Zachnad0/KICAD_DC-DC_Converter_AnalogControlSys_Mk-I/LTspiceSim/Module_2_SwitchingRegController.asc

C1: cap; 100n
C2: cap; 10n
C3: cap; 100n
C4: cap; 10n
C5: cap; 2.2µ
C6: polcap; 220µ; Rser=120m
C8: cap; 1µ; Rser=1m
D1: diode; 1N5819
I1: current; 0.4
L1: ind; 22µ; Rser=30m
M1: nmos; IPB039N04L
R1: res; 1k
R2: res; 10k
R3: res; 10k
R4: res; {R_trigGain}
R5: res; 10k
R6: res; 30k
R7: res; 1k
R8: res; 150k
R9: res; 13.2k
R10: res; 10k
R11: res; 10k
R14: res; 1k
R15: res; 1k
R16: res; 5.1k
R17: res; 1k
R18: res; 2.2k
R19: res; 2.2k
R20: res; {R_osc}
R21: res; 10k
R22: res; 12.2k
R23: res; 30k
R24: res; 10k
U1: UniversalOpAmp2; Avol=200k GBW={GBW} Slew={slewRate}; Ilimit=40m Rail={railV} Vos=0
U2: UniversalOpAmp2; Avol=200k GBW={GBW} Slew={slewRate}; Ilimit=40m Rail={railV} Vos=0
U3: UniversalOpAmp2; Avol=200k GBW={GBW} Slew={slewRate}; Ilimit=40m Rail={railV} Vos=0
U4: UniversalOpAmp2; Avol=200k GBW={GBW} Slew={slewRate}; Ilimit=40m Rail={railV} Vos=0
U5: UniversalOpAmp2; Avol=200k GBW={GBW} Slew={slewRate}; Ilimit=40m Rail={railV} Vos=0
U6: UniversalOpAmp2; Avol=200k GBW={GBW} Slew={slewRate}; Ilimit=40m Rail={railV} Vos=0
U7: UniversalOpAmp2; Avol=200k GBW={GBW} Slew={slewRate}; Ilimit=40m Rail={railV} Vos=0
U8: UniversalOpAmp2; Avol=200k GBW={GBW} Slew={slewRate}; Ilimit=40m Rail={railV} Vos=0
V2: voltage; 5
V3: voltage; 5
V5: voltage; 5
V6: voltage; 5
Named nets: V_CC, V_EE, 0, V_CLK, V_THR, V_PWM, C, D, V_O, V_TARG, E, error, integral_error, B, nMOS, V_supply
.tran 0 40m 0 0.1u startup
.meas TRAN V_b_max MAX V(b)
.param R_trigGain = 17.7k
.meas TRAN R_f1_optimal PARAM {(2.5 / V_b_max - 1) * 10k}
.param slewRate = 15Meg
.param GBW = 3Meg
.meas TRAN P_AVG_SUPPLY AVG {abs( V(V_supply) * I(V5) )} FROM 15m
.meas TRAN P_AVG_FET AVG {V(nMOS) * Id(M1)} FROM 15m
PWM Gen.
Pot. #1
PI Controller
Boost Converter
Hysterisis 100kHz Square Oscillator (+/- 10% tol.)
.param R_osc = 4.9k
Pot. #2
Supply and Target Voltages
.meas TRAN P_AVG_LOAD AVG {abs( V(V_O) * I(I1) )} FROM 15m
.meas TRAN P_EFFICIENCY PARAM {P_AVG_LOAD / P_AVG_SUPPLY}
.meas TRAN I_AVG_D1 AVG {I(D1)} FROM 10m
.meas TRAN P_AVG_D1 AVG {abs(V(nMOS,V_O) * I(D1))} FROM 15m
.param railV = 1
