Zachnad0/KICAD_DC-DC_Converter_AnalogControlSys_Mk-I/DC-DC_Converter_AnalogControlSys_Mk-I.kicad_pcb

## KiCad design DC-DC_Converter_AnalogControlSys_Mk-I.kicad_pcb (2025-12-18)

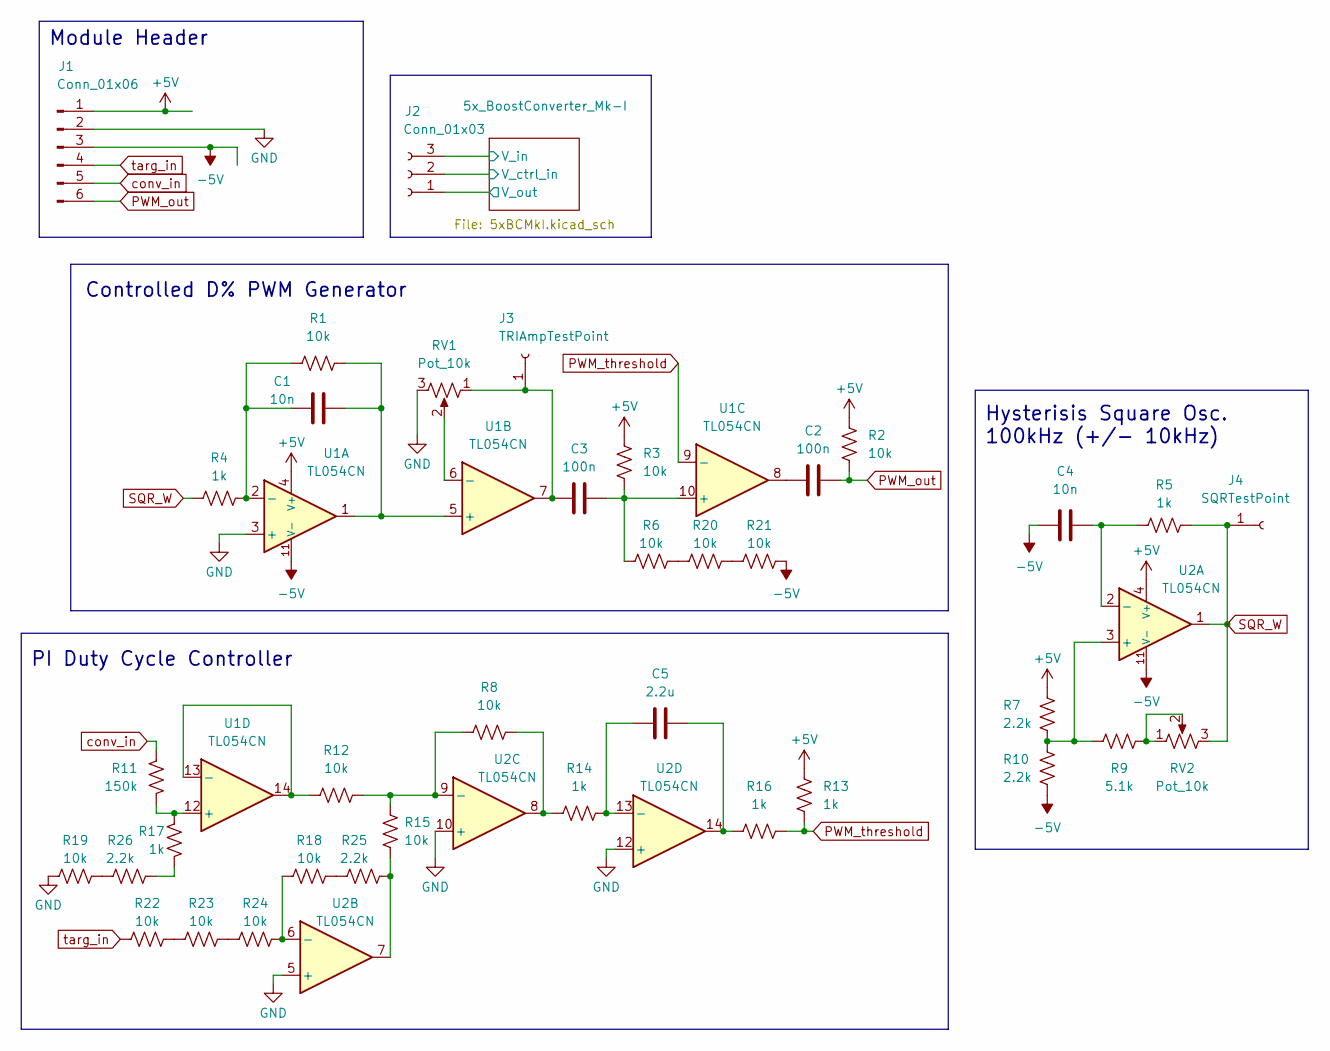
[picture p1: schematic DC-DC_Converter_AnalogControlSys_Mk-I.kicad_sch, DC-DC Converter Analog Control System Mk-I]

Parts:
C1, C4: 10n; C_0805_2012Metric_Pad1.15x1.40mm; LCSC Part # C52278
C2, C3: 100n; C_0805_2012Metric_Pad1.15x1.40mm; LCSC Part # C520083
C5: 2.2u; C_0603_1608Metric_Pad1.05x0.95mm; LCSC Part # C415535
J1: Conn_01x06; PinHeader_1x06_P2.54mm_Vertical; LCSC Part # N/A
J2: Conn_01x03; PinHeader_1x03_P2.54mm_Vertical; LCSC Part # N/A
J3: TRIAmpTestPoint; PinHeader_1x01_P2.54mm_Vertical; LCSC Part # N/A
J4: SQRTestPoint; PinHeader_1x01_P2.54mm_Vertical; LCSC Part # N/A
R1, R2, R3, R6, R8, R12, R15, R18, R19, R20, R21, R22, R23, R24: 10k; R_0805_2012Metric_Pad1.15x1.40mm; LCSC Part # C212284
R4, R5, R13, R14, R16, R17: 1k; R_0603_1608Metric_Pad0.98x0.95mm; LCSC Part # C209012
R7, R10, R25, R26: 2.2k; R_0603_1608Metric_Pad0.98x0.95mm; LCSC Part # C423061
R9: 5.1k; R_0603_1608Metric_Pad0.98x0.95mm; LCSC Part # C318133
R11: 150k; R_0805_2012Metric_Pad1.15x1.40mm; LCSC Part # C966565
RV1, RV2: Pot_10k; JIERR 3362P Pot; LCSC Part # C48997914
U1, U2: TL054CN; DIP-14_W7.62mm; LCSC Part # C1347256

Connections:
+5V: J1.1, R2.2, R3.2, R7.2, R13.1, U1.4 (V+), U2.4 (V+)
-5V: C4.1, J1.3, R10.1, R21.1, U1.11 (V-), U2.11 (V-)
/5x_BoostConverter_Mk-I/V_ctrl_in: J2.2; also elsewhere on the board
/5x_BoostConverter_Mk-I/V_in: J2.3; also elsewhere on the board
/5x_BoostConverter_Mk-I/V_out: J2.1; also elsewhere on the board
GND: J1.2, R19.2, RV1.3, U1.3 (+), U2.5 (+), U2.10 (+), U2.12 (+); also elsewhere on the board
unnamed: C2.1, U1.8
unnamed: C5.2, R16.2, U2.14
unnamed: C3.1, J3.1, RV1.1, U1.7
unnamed: R9.2, RV2.1, RV2.2
unnamed: R8.1, R14.2, U2.8
unnamed: R15.1, R25.2, U2.7
unnamed: R17.1, R26.2
unnamed: R18.1, R25.1
unnamed: R19.1, R26.1
unnamed: R20.1, R21.2
unnamed: R6.1, R20.2
unnamed: R22.1, R23.2
unnamed: R23.1, R24.2
unnamed: C1.1, R1.1, R4.2, U1.2 (-)
unnamed: C1.2, R1.2, U1.1, U1.5 (+)
unnamed: RV1.2, U1.6 (-)
unnamed: C3.2, R3.1, R6.2, U1.10 (+)
unnamed: R11.2, R17.2, U1.12 (+)
unnamed: R12.2, U1.13 (-), U1.14
unnamed: R7.1, R9.1, R10.2, U2.3 (+)
unnamed: C4.2, R5.1, U2.2 (-)
unnamed: R18.2, R24.1, U2.6 (-)
unnamed: R8.2, R12.1, R15.2, U2.9 (-)
unnamed: C5.1, R14.1, U2.13 (-)
PWM_out: C2.2, J1.6, R2.1
PWM_threshold: R13.2, R16.1, U1.9 (-)
SQR_W: J4.1, R4.1, R5.2, RV2.3, U2.1
conv_in: J1.5, R11.1
targ_in: J1.4, R22.2

Notes on the sheet:
Hysterisis Square Osc. 100kHz (+/- 10kHz)
Module Header
Controlled D% PWM Generator
PI Duty Cycle Controller

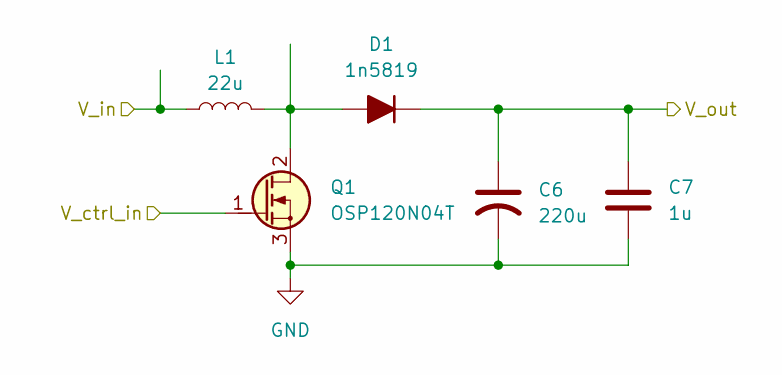
[picture p2: schematic 5xBCMkI.kicad_sch, 5-25V Boost Converter Mk-I (Uncontrolled)]

Parts:
C6: 220u; CP_Radial_D10.0mm_P5.00mm; LCSC Part # C7499951
C7: 1u; C_Axial_L3.0mm_D2.3mm_P7.50mm_Horizontal; LCSC Part # C94708
D1: 1n5819; D_DO-41_SOD81_P10.16mm_Horizontal; LCSC Part # C402218
L1: 22u; L_Radial_D12.0mm_P5.00mm_Fastron_11P; LCSC Part # C142471
Q1: OSP120N04T; TO-220-3_Vertical_GDS; LCSC Part # C51949596

Connections:
/5x_BoostConverter_Mk-I/V_ctrl_in: Q1.1 (G); also elsewhere on the board
/5x_BoostConverter_Mk-I/V_in: L1.1; also elsewhere on the board
/5x_BoostConverter_Mk-I/V_out: C6.1, C7.1, D1.1 (K); also elsewhere on the board
GND: C6.2, C7.2, Q1.3 (S); also elsewhere on the board
unnamed: D1.2 (A), L1.2, Q1.2 (D)

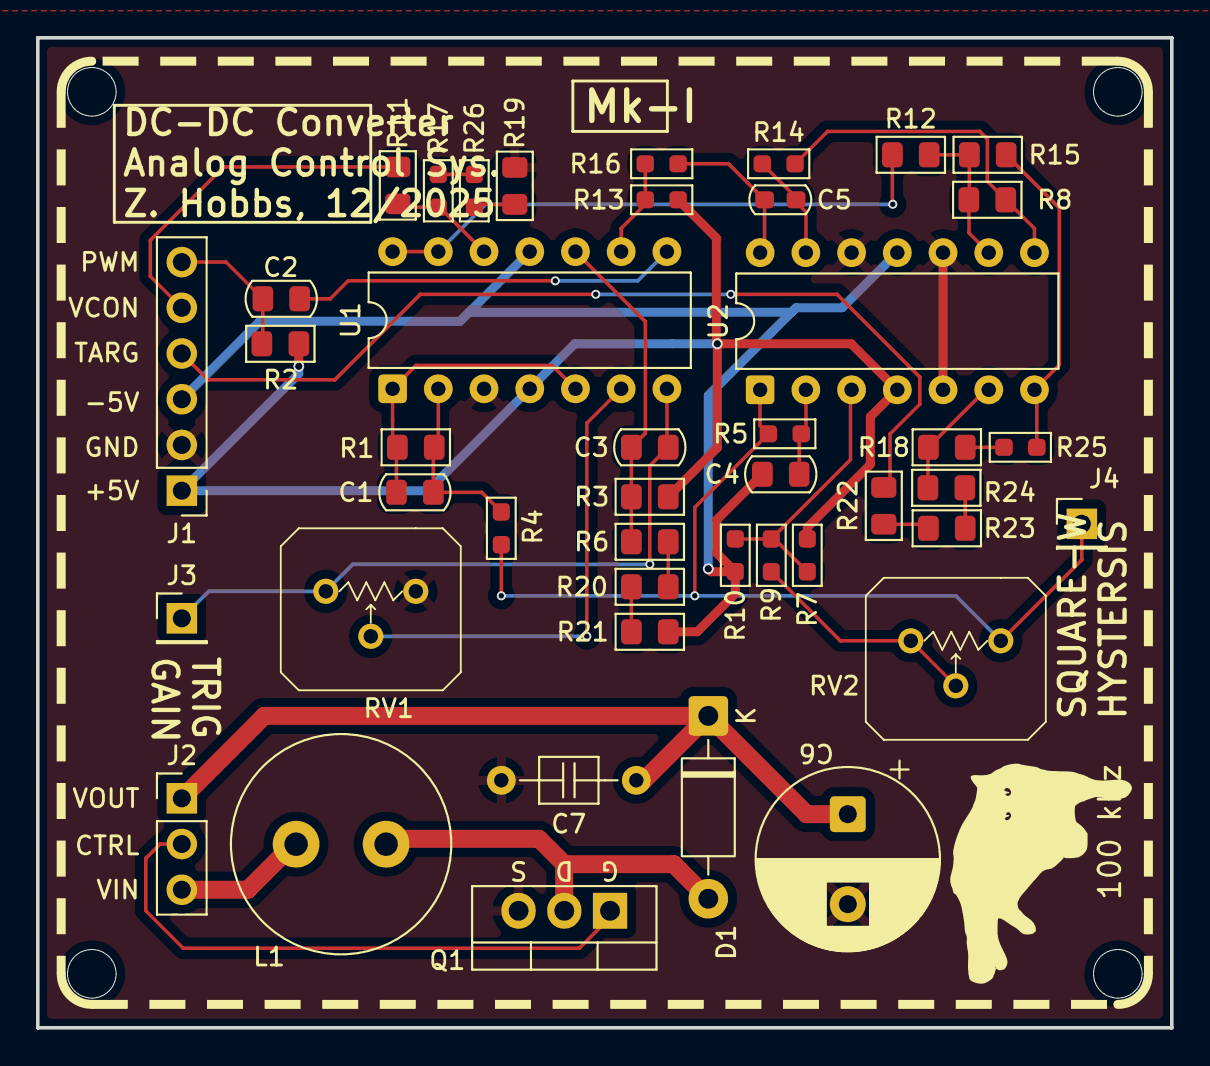
[picture p3: board DC-DC_Converter_AnalogControlSys_Mk-I.kicad_pcb from above]

Board: 2 copper layers, 63.0 x 55.0 mm, 44 parts (0 on the bottom side), 36 nets.
