Zachnad0/KICAD_DC-DC_Converter_AnalogControlSys_Mk-I/(commit log)

2025-11-29 Project files initialized
    [DC-DC_Converter_AnalogControlSys_Mk-I.kicad_pcb, DC-DC_Converter_AnalogControlSys_Mk-I.kicad_sch]
2025-12-04 ADDED potentiometer footprint. ADDED layout of PI controller and PWM generator. TODO determine clock source, then assign component values and LCSC numbers.
    [DC-DC_Converter_AnalogControlSys_Mk-I.kicad_sch]
2025-12-12 FIXED analog control system to work much better and matches the LTspice sim. ADDED optionally-usable 10W 5x boost converter module. TODO find and assign LCSC part numbers and footprints, before begin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
    [5xBCMkI.kicad_sch, DC-DC_Converter_AnalogControlSys_Mk-I.kicad_sch]
2025-12-13 ADDED LTspice simulation to repo. TODO update KiCAD schematic to match latest LTspice model.
2025-12-16 FIXED schematic to match simulation. TODO assign LCSC part numbers.
    [DC-DC_Converter_AnalogControlSys_Mk-I.kicad_sch]
2025-12-17 ADDED all LCSC part numbers and footprints. FIXED schematic (and model) to use a smaller range of resistor and capacitor values to increase cost efficiency, at the expense of control system performan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
    [5xBCMkI.kicad_sch, DC-DC_Converter_AnalogControlSys_Mk-I.kicad_sch]
2025-12-17 WIP PCB layout
    [DC-DC_Converter_AnalogControlSys_Mk-I.kicad_pcb]
2025-12-17 DONE PCB layout and routing. TODO add some silkscreen text, double-check everything, then organize BOM and JLCPCB order.
    [DC-DC_Converter_AnalogControlSys_Mk-I.kicad_pcb]
2025-12-18 ADDED silkscreen graphics. DONE all checks on PCB validity. TODO double-check schematic, find suitable replacement for TL054, then order PCB and parts.
    [DC-DC_Converter_AnalogControlSys_Mk-I.kicad_pcb]
2025-12-19 Finalized design files for assembly and organized BOM.
    [5xBCMkI.kicad_sch, DC-DC_Converter_AnalogControlSys_Mk-I.kicad_sch]
